klay326/S-Parameters_FPGA/RF Signal Generation/Pictures and Board Assembly/2023_0407_130313_015.JPG

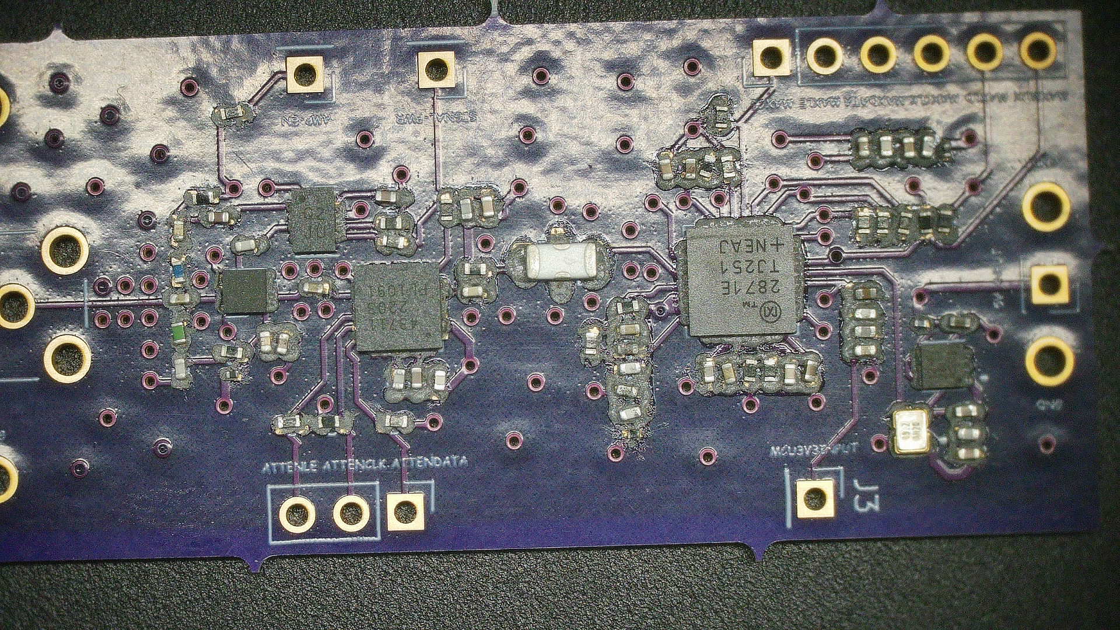
RF Signal Generation/Pictures and Board Assembly/2023_0407_130313_015.JPG
