klay326/S-Parameters_FPGA/RF Signal Generation/Pictures and Board Assembly/2023_0414_121450_022.JPG

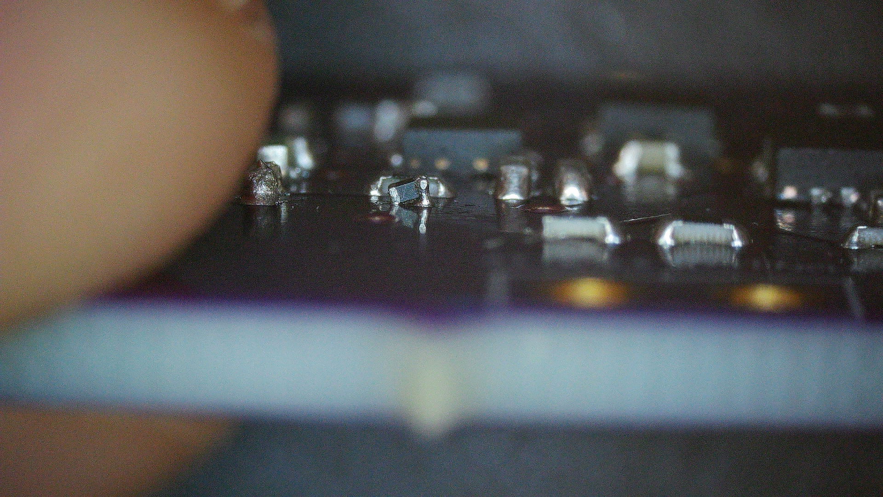
RF Signal Generation/Pictures and Board Assembly/2023_0414_121450_022.JPG
