klay326/S-Parameters_FPGA/README.md

# S-Parameters_FPGA
FPGA S Parameter Measuring Tool Suite to Aid TTU Instructor Derek Johnston with Fraudulent IC Indentification
