klay326/S-Parameters_FPGA/RF Signal Generation/Pictures and Board Assembly/2023_0407_130318_016.JPG

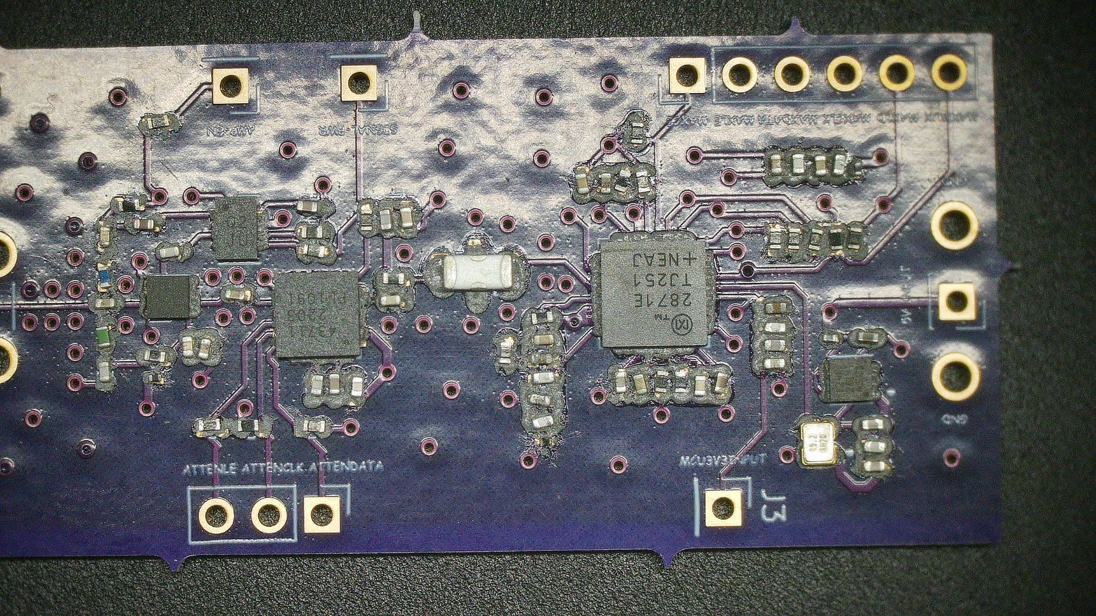
RF Signal Generation/Pictures and Board Assembly/2023_0407_130318_016.JPG
