klay326/S-Parameters_FPGA/RF Signal Generation/Pictures and Board Assembly/2023_0410_185410_017.JPG

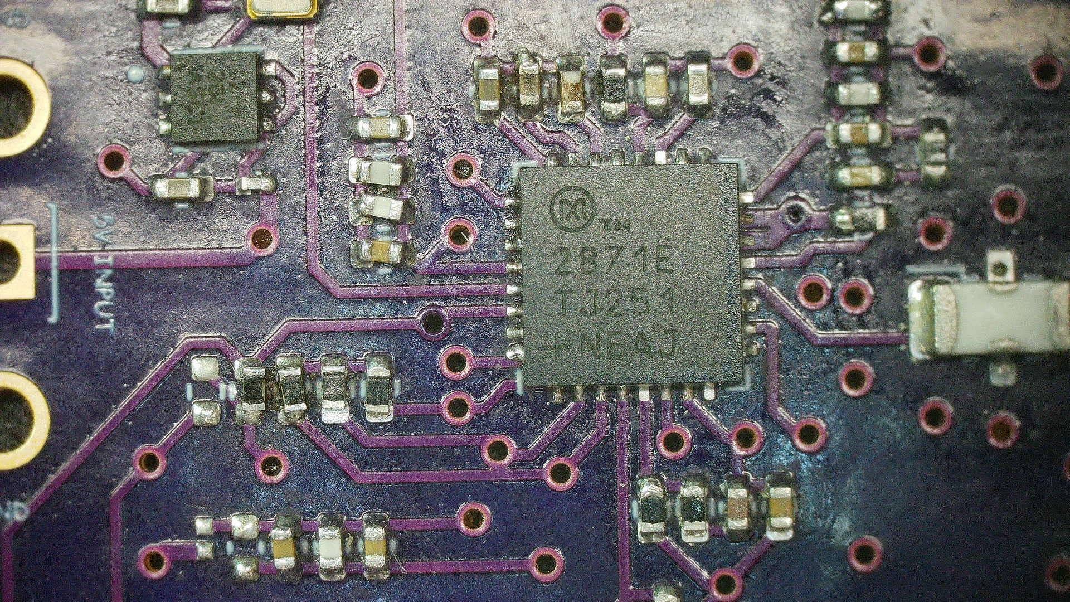
RF Signal Generation/Pictures and Board Assembly/2023_0410_185410_017.JPG
