klay326/S-Parameters_FPGA/RF Signal Generation/Pictures and Board Assembly/2023_0410_185422_018.JPG

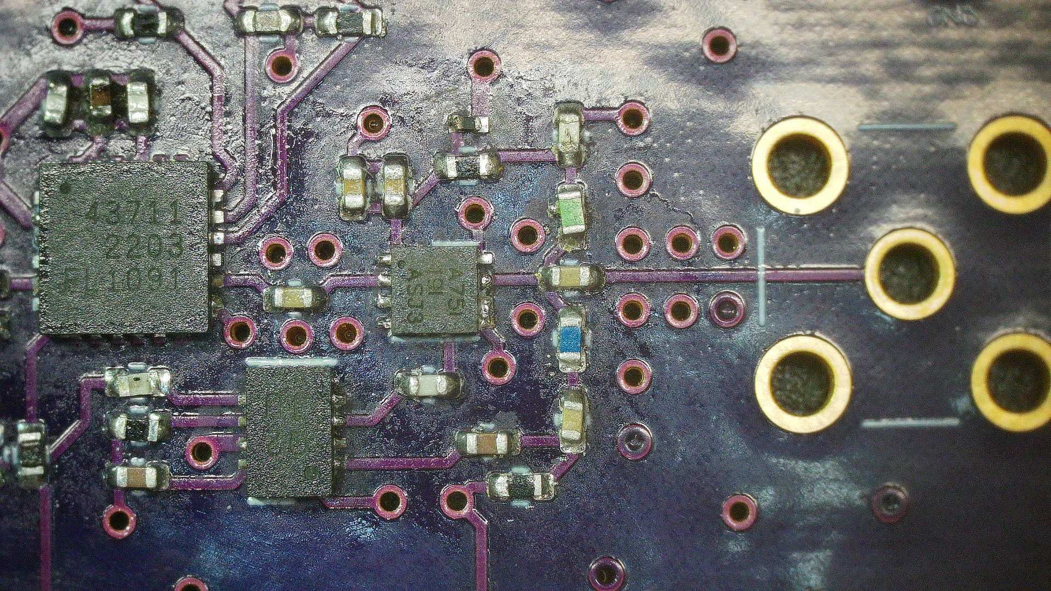
RF Signal Generation/Pictures and Board Assembly/2023_0410_185422_018.JPG
