klay326/S-Parameters_FPGA/RF Signal Generation/Pictures and Board Assembly/2023_0414_110315_021.JPG

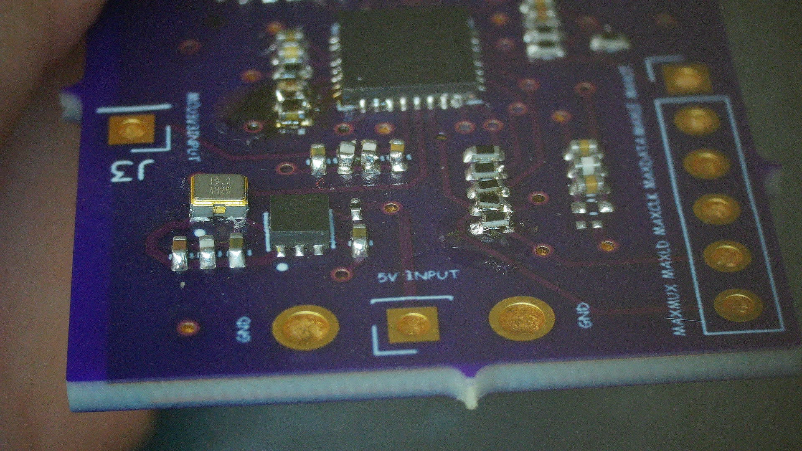
RF Signal Generation/Pictures and Board Assembly/2023_0414_110315_021.JPG
