klay326/S-Parameters_FPGA/Weekly Meeting Notes and Questions/Note Feb 27, 2023 at 11_09_07 AM.pdf

4us | 6 layer
1 | High speed

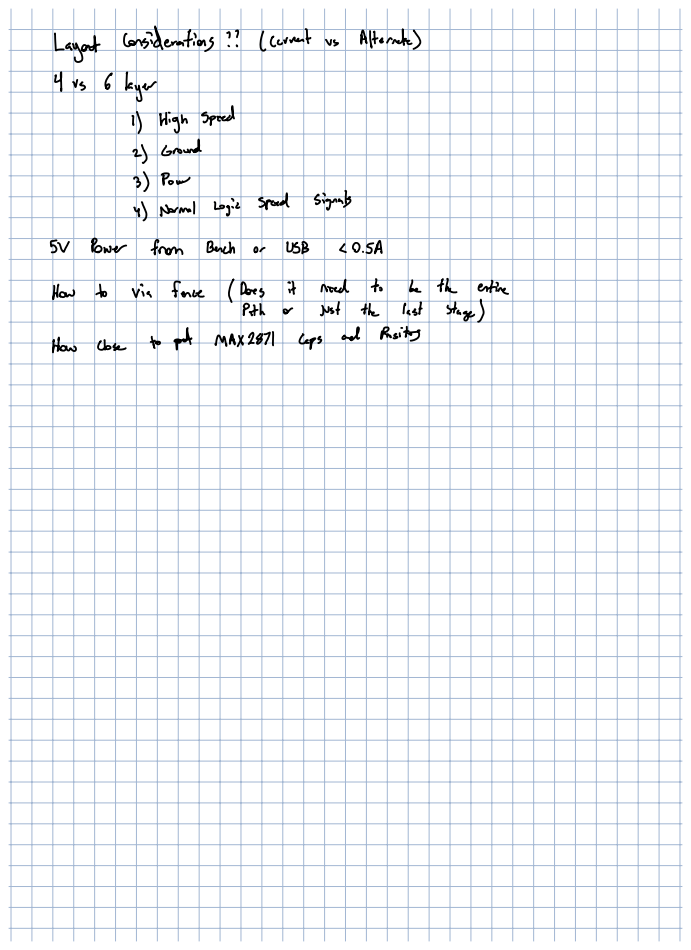
[picture p8: page 1]
Power; from; Bench; USB; OSA

Lagat | | Considerations | carat us | Alternate

2 | Ground
3 | Pour
4 Normal | | Logic Spend | Signals

Wow to | | via | | fence | | Does | it | need | | to | be the | | entire

Path or | | lust | the | | last | stage

How | Close | | to ft | | MAX²⁸⁷¹ | | Cops ad | | | Risity
