klay326/S-Parameters_FPGA/Weekly Meeting Notes and Questions/Note Jan 30, 2023 at 11_05_02 PM.pdf

| | | | | | TEEJ

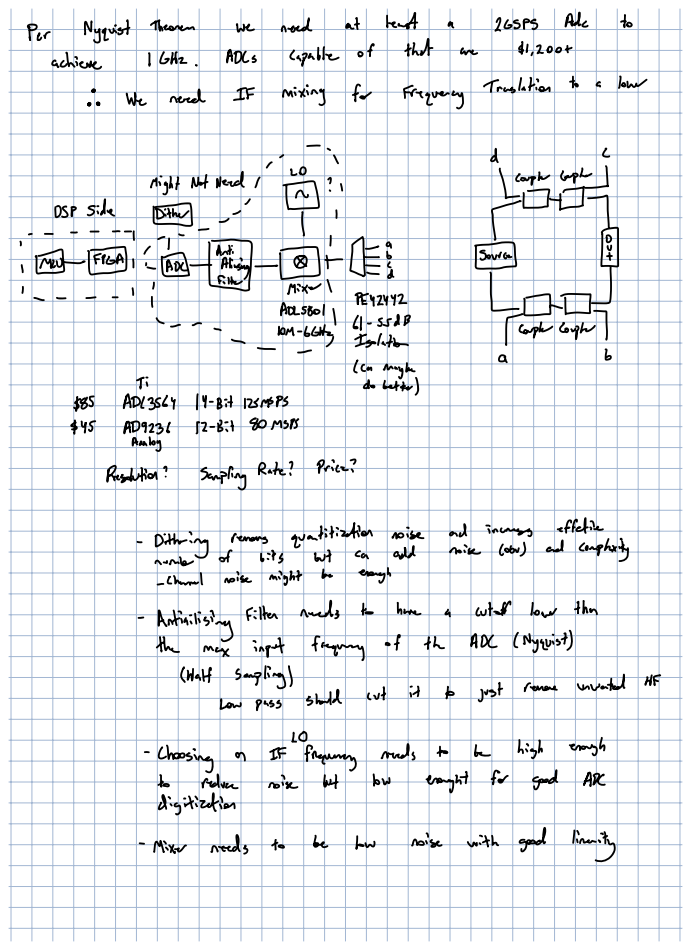
[picture p9: page 1]
Per; Nyquist; Theorem; need; least; Adc; Resolution; Sampling Rate; Prinz; Dithring; venous; quatitiation; noise; and incomes; effetie; none; bits; out; add; obv; corphxity

achieve | | | 1GHz | | ADCs | | capable | of | that | are | | 1,20et

translation | | to a | low

8 | We | | need | IF | mixing | | for | frequency

yes
EE.IQ | IIFtCE

AOL.SE | me | I | 61 man | 55dB | 4Eworm | I I

jenson | Isolate

d better

85 | AOI3s6y 14Bit¹²m58s
45 | AD9236 Analog | 12bit 80m58

Chanel noise | | | | might be | | | engl
Antiailising filter | | | | | | needs | | to | him | | a | | cutoff low thn
the mex | | | | input | | | freeing of | | | the | | AOL | | Nyquist
half | sapling
Low pass

should | cut | it | to | just | Venere unrated | HF

Choosing | | | n | If frequency | | | and | | to | | be | high | enough
to | reduce | | | noise | but | | low | enough | | | for | god | | AOC
digitization

Mixer | | needs | | to | be | low | | noise | | with | | good | limity
