klay326/S-Parameters_FPGA/Weekly Meeting Notes and Questions/Note Mar 5, 2023 at 11_59_43 PM.pdf

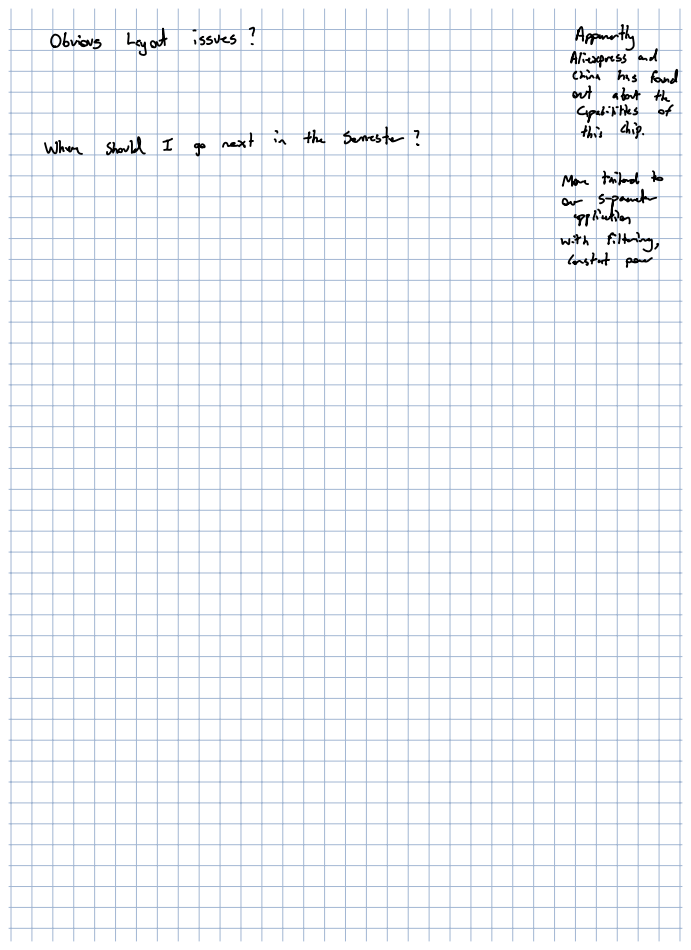
[picture p10: page 1]

Obvious | Legat | issues | Appmutly

Aliexpress and
China has found
out | capabilities of | about the
this chip

When | should | I | go next | in the semester

Man tailed to
on | Spaint application

with | filtering
constant | | per
