klay326/S-Parameters_FPGA/Weekly Meeting Notes and Questions/Note Apr 24, 2023 at 9_44_33 AM.pdf

### Lotty Crystal

spthes ie | TFE¹ | ALEFi | EI | RFE

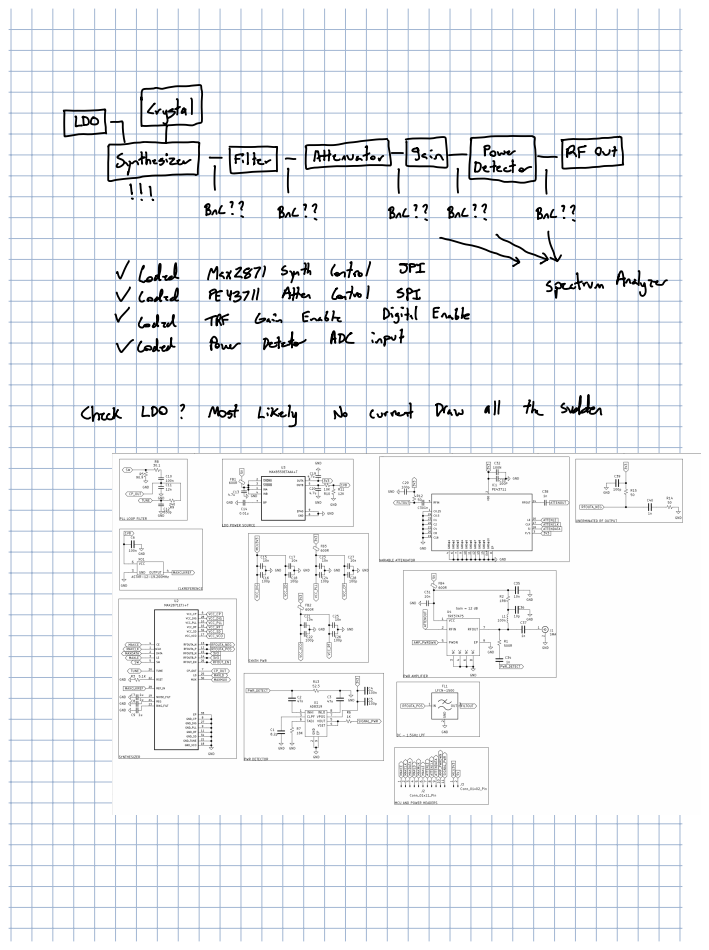
[picture p11: page 1]
Inc; Codd; TRF; Gain Enable; til; Enable; Check; Most Likely

one
I | | 3 | | | It | amanda

coded | Pew veteto | | Aoc | in
