klay326/S-Parameters_FPGA/Weekly Meeting Notes and Questions/Note Jan 13, 2023 at 11_22_45 AM.pdf

| Parents | | used

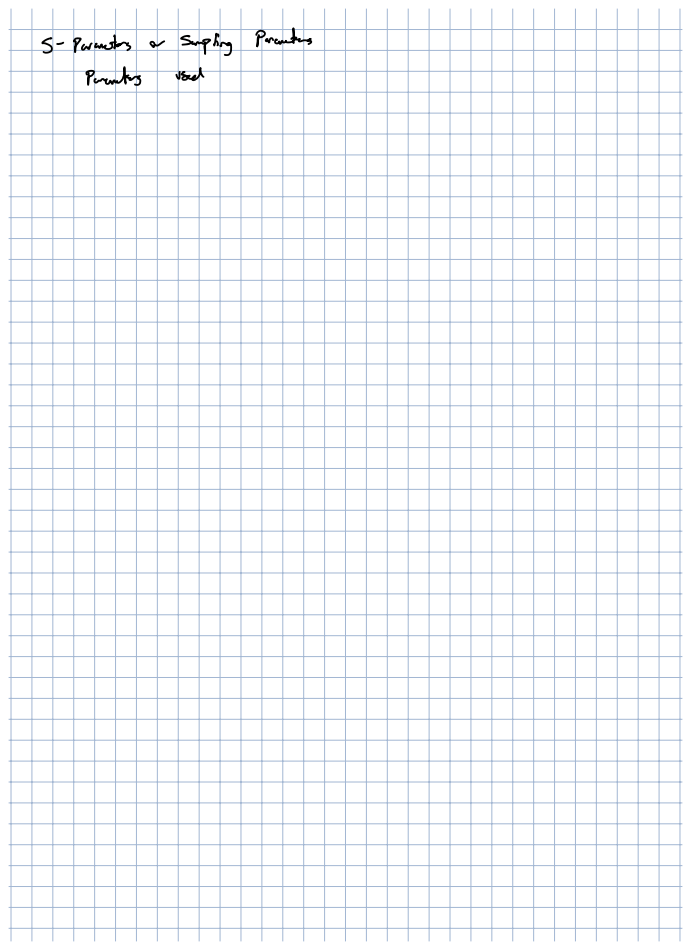
[picture p12: page 1]

S Parameters | | or Sampling | | Parentes
