klay326/S-Parameters_FPGA/Weekly Meeting Notes and Questions/Note Jan 17, 2023 at 2_01_35 AM.pdf

| | D

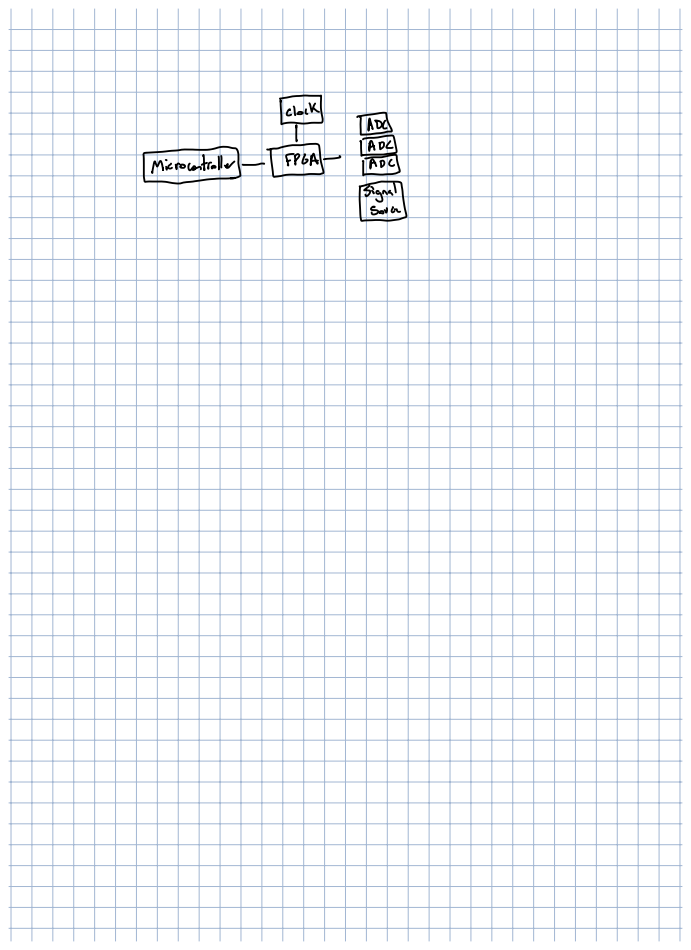
[picture p13: page 1]

Microntrollep | fi | fi
