klay326/S-Parameters_FPGA/Weekly Meeting Notes and Questions/Note Jan 18, 2023 at 4_26_04 PM.pdf

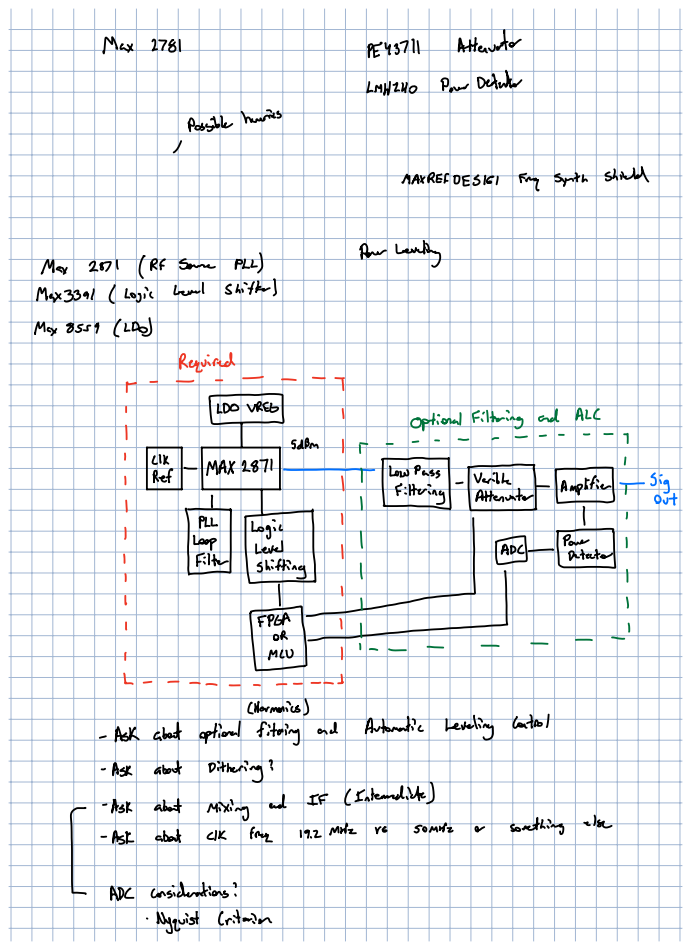
[picture p14: page 1]
mmm; iiÉÉIiIÉIÉ; Ask abet option; fitting; and; Automatic; Leveling Latrol

Max 2781 | | PE⁴³⁷¹¹ | | Attenuate

2MW40 | DewDefends

Possiblehurts

PenLeveling

Max | 2871 | | Rf Some | PLL
Max3391 | | Login Level | | Shifter

Ask | about | Dithering
Ask | about | mixing | | and | | If | Intermediate
Ask abet | | | k | h | 9.2 | | h | h

ADC considerations
Nyquist Criterion

## NoisePerforce

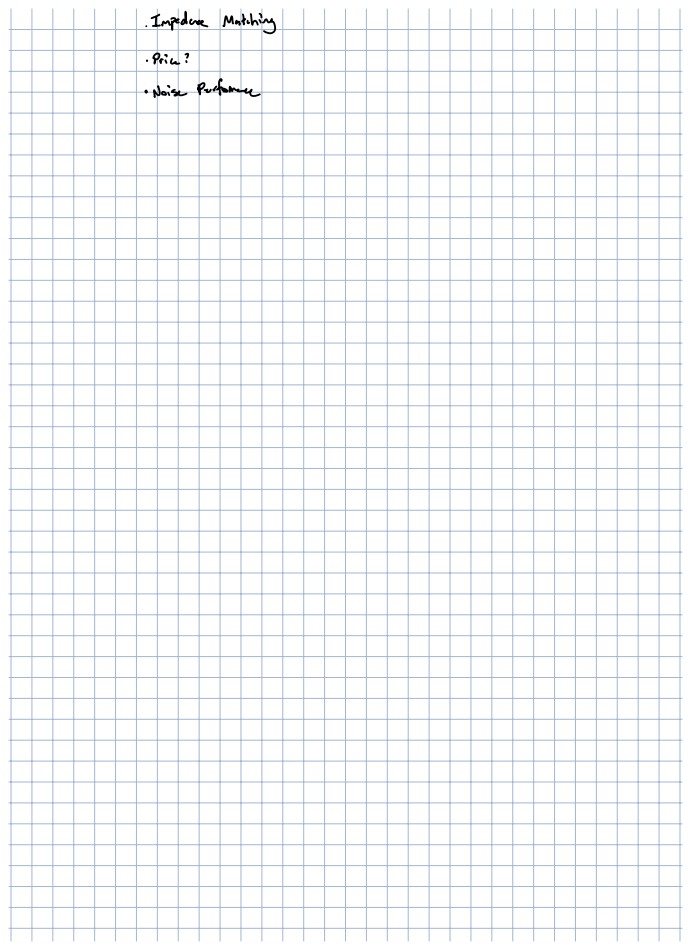
[picture p15: page 2]
Impedance Mathing

Price
