klay326/S-Parameters_FPGA/(list of files, drawings)

Other design files:
RF Signal Generation/PCB Schematic and Design/RF Signal Source/freerouting.dsn
