klay326/S-Parameters_FPGA/RF Signal Generation/PCB Schematic and Design/RF Signal Source/RF Signal Source.kicad_pcb

## KiCad design RF Signal Generation/PCB Schematic and Design/RF Signal Source/RF Signal Source.kicad_pcb (2023-05-01)

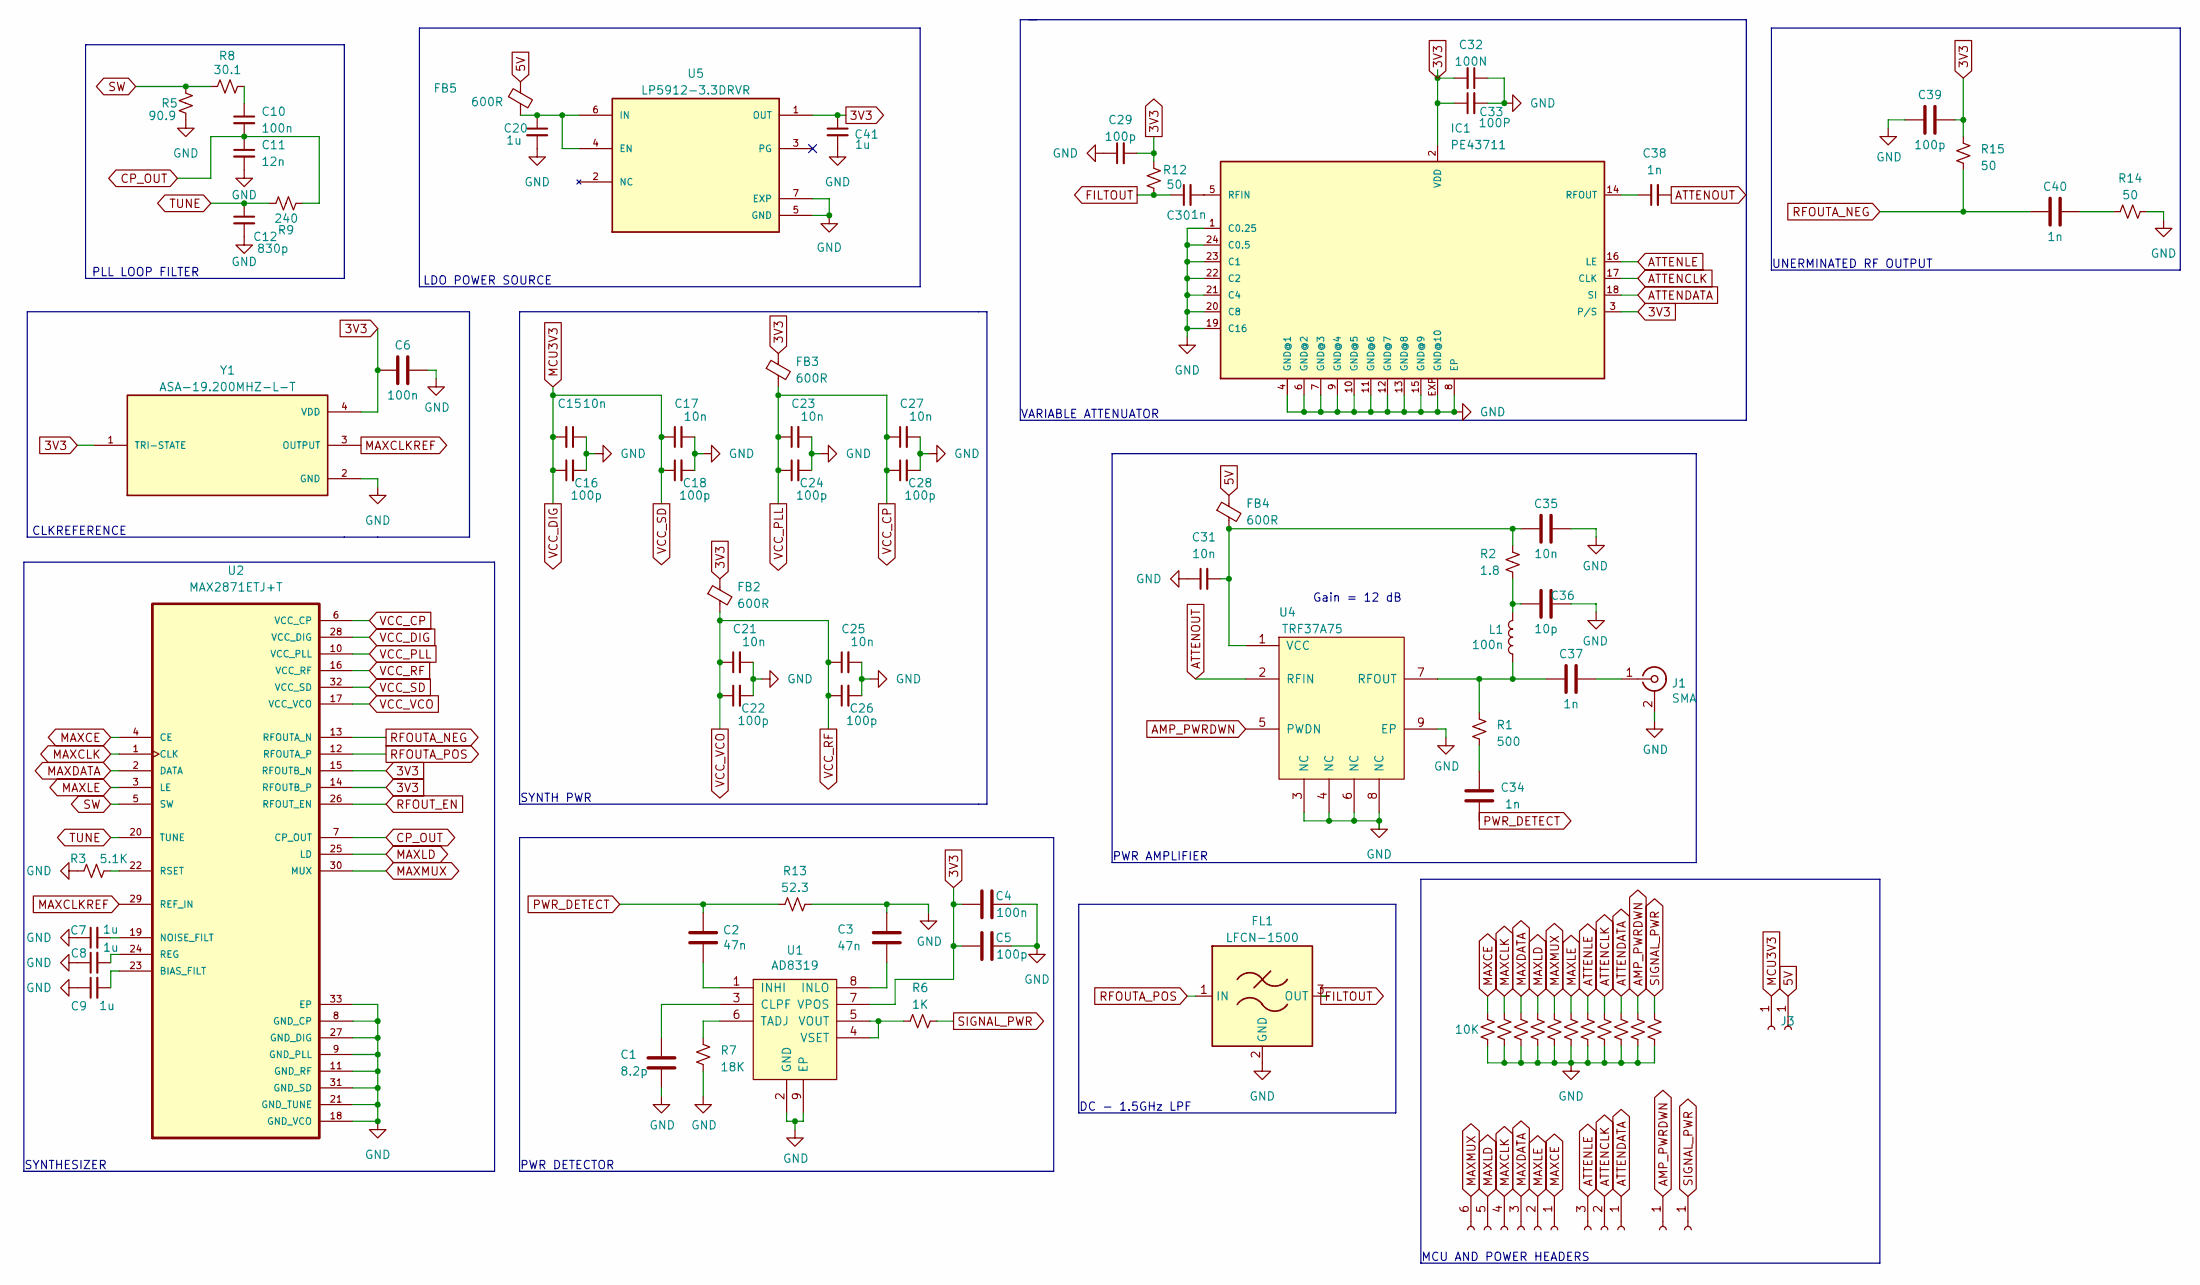
[picture p16: schematic RF Signal Source.kicad_sch]

Parts:
C1: 8.2p; C_0402_1005Metric
C2, C3: 47n; C_0402_1005Metric
C4, C6, C10: 100n; C_0402_1005Metric
C5, C16, C18, C22, C24, C26, C28, C29, C39: 100p; C_0402_1005Metric
C7, C8, C9, C20, C41: 1u; C_0402_1005Metric
C11: 12n; C_0402_1005Metric
C12: 830p; C_0402_1005Metric
C15, C17, C21, C23, C25, C27, C31, C35: 10n; C_0402_1005Metric
C30, C34, C37, C38, C40: 1n; C_0402_1005Metric
C32: 100N; C_0402_1005Metric
C33: 100P; C_0402_1005Metric
C36: 10p; C_0402_1005Metric
FB2, FB3, FB4, FB5: 600R; BEADC0603X33N
FL1: LFCN-1500; Filter_Mini-Circuits_FV1206
IC1: PE43711; VQFN24-4X4
J1: SMA; LINX_CONSMA002-G
J3, J7, J8: Conn_01x01_Socket; PinHeader_1x01_P2.54mm_Vertical
J4: Conn_01x01_Socket; PinSocket_1x01_P2.54mm_Vertical
J5: Conn_01x06_Socket; PinHeader_1x06_P2.54mm_Vertical
J6: Conn_01x03_Socket; PinHeader_1x03_P2.54mm_Vertical
L1: 100n; L_0402_1005Metric
R1: 500; R_0402_1005Metric
R2: 1.8; R_0402_1005Metric
R3: 5.1K; R_0402_1005Metric
R4, R10, R11, R16, R17, R18, R19, R20, R21, R22, R23: 10K; R_0402_1005Metric
R5: 90.9; R_0402_1005Metric
R6: 1K; R_0402_1005Metric
R7: 18K; R_0402_1005Metric
R8: 30.1; R_0402_1005Metric
R9: 240; R_0402_1005Metric
R12, R14, R15: 50; R_0402_1005Metric
R13: 52.3; R_0402_1005Metric
U1: AD8319; DFN-8-1EP_2x3mm_P0.5mm_EP0.61x2.2mm; DigiKey AD8319ACPZ-R7CT-ND
U2: MAX2871ETJ+T; QFN-32-1EP_5x5mm_P0.5mm_EP3.3x3.3mm_ThermalVias
U4: TRF37A75; DFN-8-1EP_2x2mm_P0.5mm_EP0.9x1.5mm; DigiKey 296-37886-1-ND
U5: LP5912-3.3DRVR; SON65P200X200X80-7N; PARTREV D
Y1: ASA-19.200MHZ-L-T; XTAL_ASA-19.200MHZ-L-T; PARTREV 01.24.14

Connections:
3V3: C4.2, C5.2, C6.2, C29.2, C32.2, C33.1, C39.1, C41.1, FB2.1, FB3.1, IC1.2 (VDD), IC1.3 (P/S), R12.1, R15.1, U1.7 (VPOS), U2.14 (RFOUTB_P), U2.15 (RFOUTB_N), U5.1 (OUT), Y1.1 (TRI-STATE), Y1.4 (VDD)
5V: FB4.1, FB5.1, J4.1
AMP_PWRDWN: J7.1, R22.1, U4.5 (PWDN)
ATTENCLK: IC1.17 (CLK), J6.2, R20.1
ATTENDATA: IC1.18 (SI), J6.1, R21.1
ATTENLE: IC1.16 (LE), J6.3, R19.1
ATTENOUT: C38.2, U4.2 (RFIN)
CP_OUT: C10.2, C11.1, R9.2, U2.7 (CP_OUT)
FILTOUT: C30.1, FL1.3 (OUT), R12.2
GND: C1.2, C3.1, C4.1, C5.1, C6.1, C7.1, C8.1, C9.1, C11.2, C12.2, C15.1, C16.2, C17.2, C18.2, C20.2, C21.2, C22.2, C23.2, C24.2, C25.2, C26.2, C27.2, C28.2, C29.1, C31.1, C32.1, C33.2, C35.2, C36.2, C39.2, C41.2, FL1.2 (GND), FL1.4 (GND), IC1.1 (C0.25), IC1.4 (GND@1), IC1.6 (GND@2), IC1.7 (GND@3), IC1.8 (EP), IC1.9 (GND@4), IC1.10 (GND@5), IC1.11 (GND@6), IC1.12 (GND@7), IC1.13 (GND@8), IC1.15 (GND@9), IC1.19 (C16), IC1.20 (C8), IC1.21 (C4), IC1.22 (C2), IC1.23 (C1), IC1.24 (C0.5), IC1.EXP (GND@10), J1.2 (Ext), J1.S1, J1.S2, J1.S3, J1.S4, R3.1, R4.2, R5.2, R7.2, R10.2, R11.2, R13.2, R14.2, R16.2, R17.2, R18.2, R19.2, R20.2, R21.2, R22.2, R23.2, U1.2 (GND), U1.9 (EP), U2.8 (GND_CP), U2.9 (GND_PLL), U2.11 (GND_RF), U2.18 (GND_VCO), U2.21 (GND_TUNE), U2.27 (GND_DIG), U2.31 (GND_SD), U2.33 (EP), U4.3 (NC), U4.4 (NC), U4.6 (NC), U4.8 (NC), U4.9 (EP), U5.5 (GND), U5.7 (EXP), Y1.2 (GND)
MAXCE: J5.1, R4.1, U2.4 (CE)
MAXCLK: J5.4, R10.1, U2.1 (CLK)
MAXCLKREF: U2.29 (REF_IN), Y1.3 (OUTPUT)
MAXDATA: J5.3, R11.1, U2.2 (DATA)
MAXLD: J5.5, R16.1, U2.25 (LD)
MAXLE: J5.2, R18.1, U2.3 (LE)
MAXMUX: J5.6, R17.1, U2.30 (MUX)
MCU3V3: C15.2, C16.1, C17.1, C18.1, J3.1, U2.28 (VCC_DIG), U2.32 (VCC_SD)
unnamed: C10.1, R8.2
unnamed: C34.1, R1.2
unnamed: C36.1, L1.1, R2.2
unnamed: C40.1, R14.1
unnamed: C30.2, IC1.5 (RFIN)
unnamed: C38.1, IC1.14 (RFOUT)
unnamed: C37.1, J1.1 (In)
unnamed: C1.1, U1.3 (CLPF)
unnamed: C2.2, U1.1 (INHI)
unnamed: C3.2, U1.8 (INLO)
unnamed: R7.1, U1.6 (TADJ)
unnamed: R6.1, U1.4 (VSET), U1.5 (VOUT)
unnamed: C9.2, U2.23 (BIAS_FILT)
unnamed: C7.2, U2.19 (NOISE_FILT)
unnamed: C8.2, U2.24 (REG)
unnamed: R3.2, U2.22 (RSET)
unnamed: C37.2, L1.2, R1.1, U4.7 (RFOUT)
unnamed: C31.2, C35.1, FB4.2, R2.1, U4.1 (VCC)
unnamed: C20.1, FB5.2, U5.4 (EN), U5.6 (IN)
PWR_DETECT: C2.1, C34.2, R13.1
RFOUTA_NEG: C40.2, R15.2, U2.13 (RFOUTA_N)
RFOUTA_POS: FL1.1 (IN), U2.12 (RFOUTA_P)
RFOUT_EN: U2.26 (RFOUT_EN)
SIGNAL_PWR: J8.1, R6.2, R23.1
SW: R5.1, R8.1, U2.5 (SW)
TUNE: C12.1, R9.1, U2.20 (TUNE)
VCC_CP: C23.1, C24.1, C27.1, C28.1, FB3.2, U2.6 (VCC_CP), U2.10 (VCC_PLL)
VCC_RF: C21.1, C22.1, C25.1, C26.1, FB2.2, U2.16 (VCC_RF), U2.17 (VCC_VCO)

Notes on the sheet:
DC - 1.5GHz LPF
MCU AND POWER HEADERS
LDO POWER SOURCE
UNERMINATED RF OUTPUT
SYNTH PWR
VARIABLE ATTENUATOR
Gain = 12 dB
PWR DETECTOR
PWR AMPLIFIER
CLKREFERENCE
PLL LOOP FILTER
SYNTHESIZER

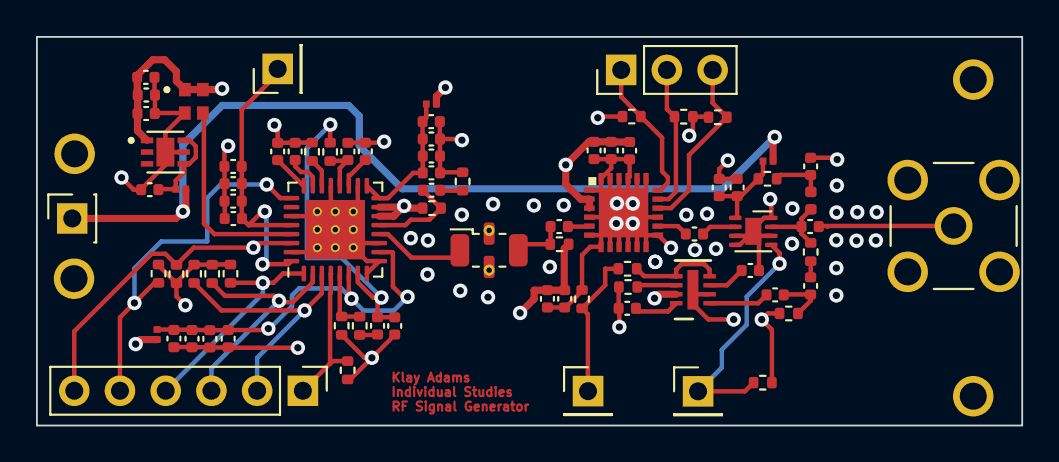
[picture p17: board RF Signal Source.kicad_pcb from above]

Board: 4 copper layers, 54.7 x 21.6 mm, 80 parts (0 on the bottom side), 45 nets.
