klay326/S-Parameters_FPGA/RF Signal Generation/Arduino Code/Signal Generator Arduino Test/SignalGenerator/SignalGenerator.ino

#include <SPI.h>

// Define the pins used for communication with the MAX2871
#define MAXMUX_PIN 2
#define MAXLD_PIN 3
#define MAXCLK_PIN 4
#define MAXDATA_PIN 5
#define MAXLE_PIN 6
#define MAXCE_PIN 7

// Define the pins used for communication with the AD8319
#define AD8319_DATA_PIN A0

// Define the pins used for communication with the PE43711
#define PE43711_LE_PIN 8
#define PE43711_DATA_PIN 9
#define PE43711_CLK_PIN 10

// Define the pins used for communication with the TRF75
#define TRF75_ENABLE_PIN 11

// Define the SPI settings
#define SPI_CLOCK 4000000
#define SPI_MODE SPI_MODE3
#define SPI_BIT_ORDER MSBFIRST

// Define the default values for the components
#define DEFAULT_FREQUENCY 5000000000
#define DEFAULT_OUTPUT_POWER 0
#define DEFAULT_ATTENUATION 0

// Define the variables for the components
unsigned long frequency = DEFAULT_FREQUENCY;
int output_power = DEFAULT_OUTPUT_POWER;
int attenuation = DEFAULT_ATTENUATION;

void setup() {
  // Initialize the SPI bus
  SPI.begin();
  SPI.setClockDivider(SPI_CLOCK);
  SPI.setDataMode(SPI_MODE);
  SPI.setBitOrder(SPI_BIT_ORDER);

  // Initialize the pins for the MAX2871
  pinMode(MAXMUX_PIN, OUTPUT);
  digitalWrite(MAXMUX_PIN, LOW);
  pinMode(MAXLD_PIN, OUTPUT);
  digitalWrite(MAXLD_PIN, HIGH);
  pinMode(MAXCLK_PIN, OUTPUT);
  pinMode(MAXDATA_PIN, OUTPUT);
  pinMode(MAXLE_PIN, OUTPUT);
  digitalWrite(MAXLE_PIN, HIGH);
  pinMode(MAXCE_PIN, OUTPUT);
  digitalWrite(MAXCE_PIN, HIGH);

  // Initialize the pins for the AD8319
  pinMode(AD8319_DATA_PIN, INPUT);

  // Initialize the pins for the PE43711
  pinMode(PE43711_LE_PIN, OUTPUT);
  digitalWrite(PE43711_LE_PIN, HIGH);
  pinMode(PE43711_DATA_PIN, OUTPUT);
  pinMode(PE43711_CLK_PIN, OUTPUT);
  digitalWrite(PE43711_CLK_PIN, LOW);

  // Initialize the pins for the TRF75
  pinMode(TRF75_ENABLE_PIN, OUTPUT);
  digitalWrite(TRF75_ENABLE_PIN, LOW);

  // Initialize the components
  max2871_init();
  ad8319_init();
  pe43711_init();
  trf75_init();
}

void loop() {
  // Change the frequency of the MAX2871
  frequency = 200000000;
  max2871_set_frequency(frequency);

  // Change the output power of the MAX2871 and TRF75
  output_power = -10;
  max2871_set_output_power(output_power);
  trf75_set_output_power(output_power);

  // Change the attenuation of the PE43711
  attenuation = 4;
  pe43711_set_attenuation(attenuation);

  // Change the output power of the AD8319
  output_power = -20;
  ad8319_set_output_power(output_power);

  delay(1000);
}

// Functions for the MAX2871
void max2871_init() {
  // Set the default values
  max2871_set_frequency(DEFAULT_FREQUENCY);
  max2871_set_output_power(DEFAULT_OUTPUT_POWER);
}

void max2871_set_frequency(unsigned long freq) {
  // Calculate the frequency control word
  unsigned long fword = freq * pow(2, 24) / 1000000000;

  // Send the frequency control word over SPI
  for (int i = 0; i < 24; i++) {
    digitalWrite(MAXDATA_PIN, (fword >> (23 - i)) & 0x01);
    digitalWrite(MAXCLK_PIN, HIGH);
    digitalWrite(MAXCLK_PIN, LOW);
  }

  // Latch the frequency control word
  digitalWrite(MAXLE_PIN, LOW);
  digitalWrite(MAXLE_PIN, HIGH);
}

void max2871_set_output_power(int power) {
  // Calculate the output power control word
  int pword = (power + 18) / 6;

  // Send the output power control word over SPI
  for (int i = 0; i < 6; i++) {
  digitalWrite(MAXDATA_PIN, (pword >> (5 - i)) & 0x01);
  digitalWrite(MAXCLK_PIN, HIGH);
  digitalWrite(MAXCLK_PIN, LOW);
}
  // Latch the output power control word
  digitalWrite(MAXLE_PIN, LOW);
  digitalWrite(MAXLE_PIN, HIGH);
}

// Functions for the AD8319
void ad8319_init() {
  // Set the default values
  ad8319_set_output_power(DEFAULT_OUTPUT_POWER);
}

void ad8319_set_output_power(int power) {
// Calculate the output power voltage
  float voltage = pow(10, power / 20.0);
}

// Functions for the PE43711
void pe43711_init() {
// Set the default values
pe43711_set_attenuation(DEFAULT_ATTENUATION);
}
  void pe43711_set_attenuation(int attenuation) {
  // Calculate the attenuation control word
  int aword = (attenuation + 31) * 2;

  // Send the attenuation control word over SPI
  digitalWrite(PE43711_LE_PIN, LOW);
  digitalWrite(PE43711_CLK_PIN, LOW);
  for (int i = 0; i < 7; i++) {
    digitalWrite(PE43711_DATA_PIN, (aword >> (6 - i)) & 0x01);
    digitalWrite(PE43711_CLK_PIN, HIGH);
    digitalWrite(PE43711_CLK_PIN, LOW);
  }
  digitalWrite(PE43711_LE_PIN, HIGH);
}

// Functions for the TRF75
void trf75_init() {
  // Set the default values
  trf75_set_output_power(DEFAULT_OUTPUT_POWER);
}

void trf75_set_output_power(int power) {
  // Calculate the output power voltage
  float voltage = pow(10, power / 20.0) * 0.2;

  // Send the voltage to the enable pin
  if (voltage > -1) {
    digitalWrite(TRF75_ENABLE_PIN, HIGH);
  } else {
    digitalWrite(TRF75_ENABLE_PIN, LOW);
  }
}
